socjordi/reflow-soldering-hotplate/README.md

# reflow-soldering-hotplate

This project is a reflow soldering hotplate. A reflow soldering hotplate is a heated surface used to solder surface-mount components onto a PCB by reflowing solder paste. It works by heating the PCB to a controlled temperature profile, melting the solder paste, and forming strong electrical and mechanical connections between the components and the board.

It's composed of a 500 W aluminium heating plate, a fan for the cooling phase, an ESP32-C3 microcontroller, an OLED display, 2 relays, a K-type thermopar and some other components. The total cost of materials was about 42 €.

The profiles can be read or write on wifi, as well as the log of the last reflow cycle.

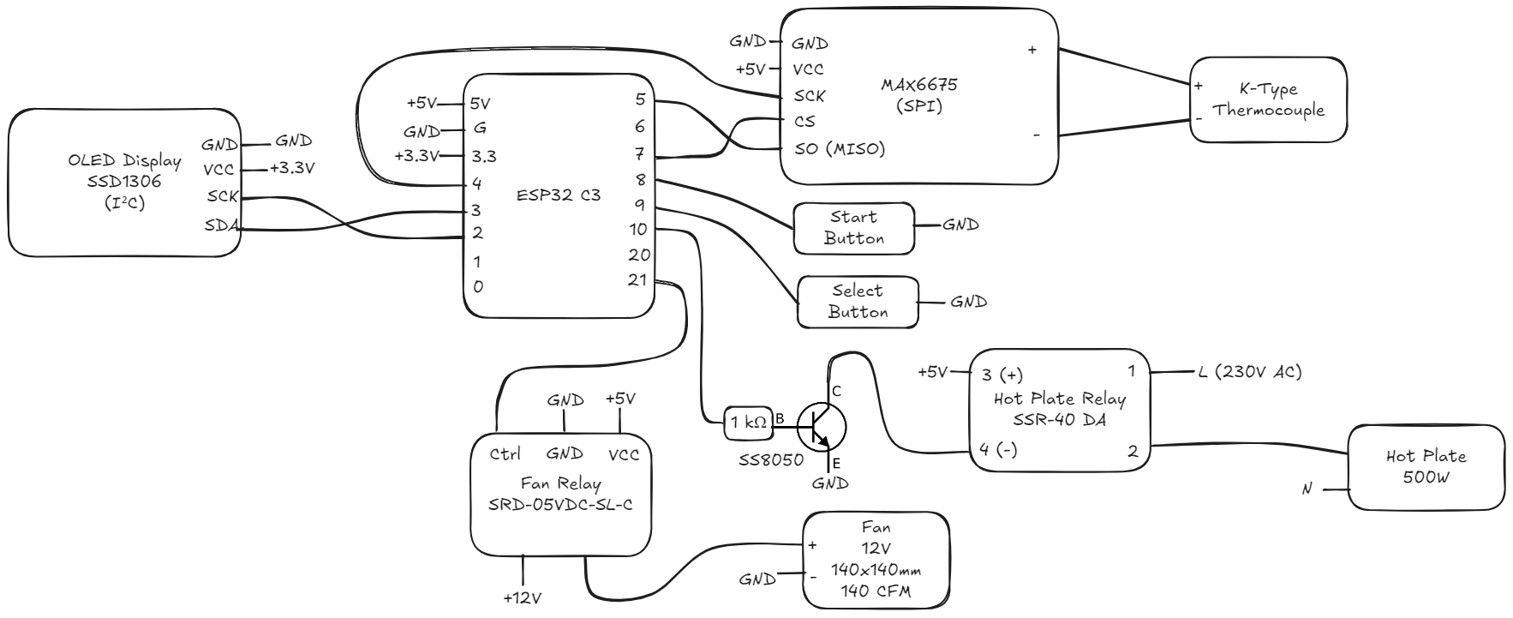
[picture p1: images/schematics.png]

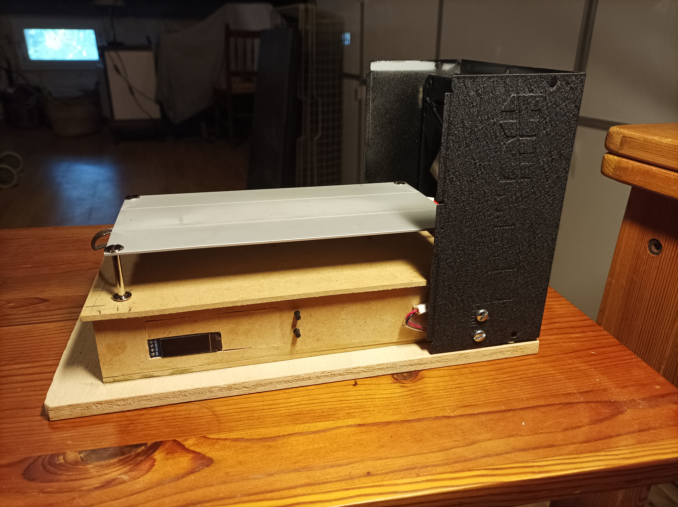
[picture p2: images/IMG_20250325_150605.jpg]

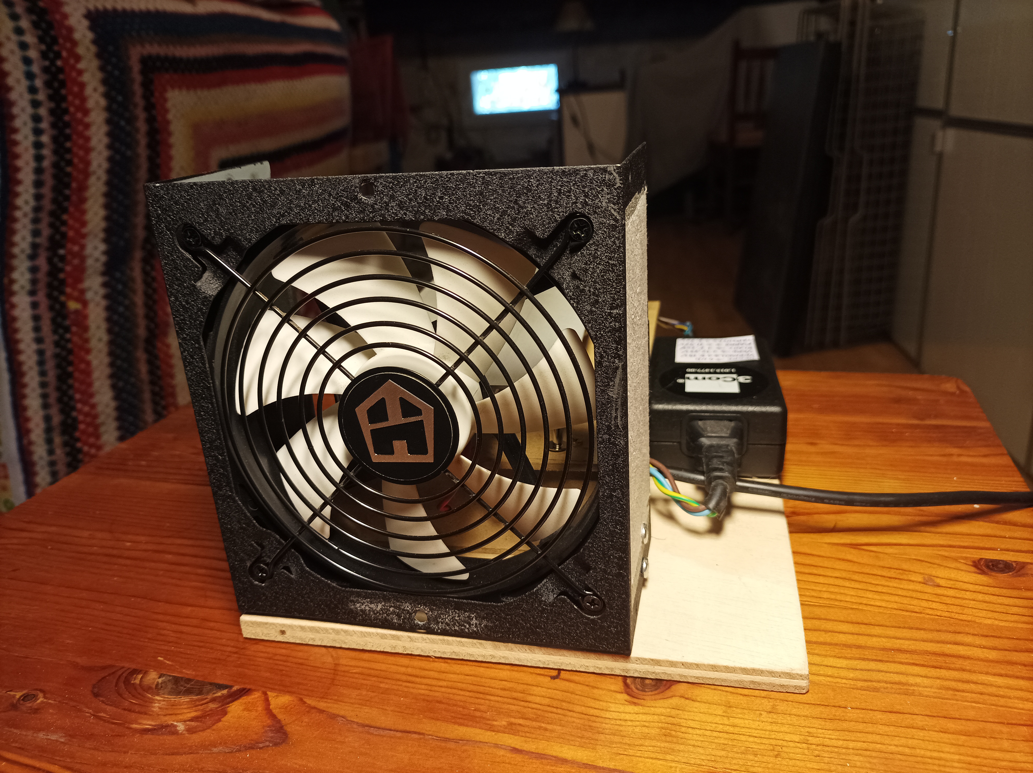
[picture p3: images/IMG_20250325_150620.jpg]

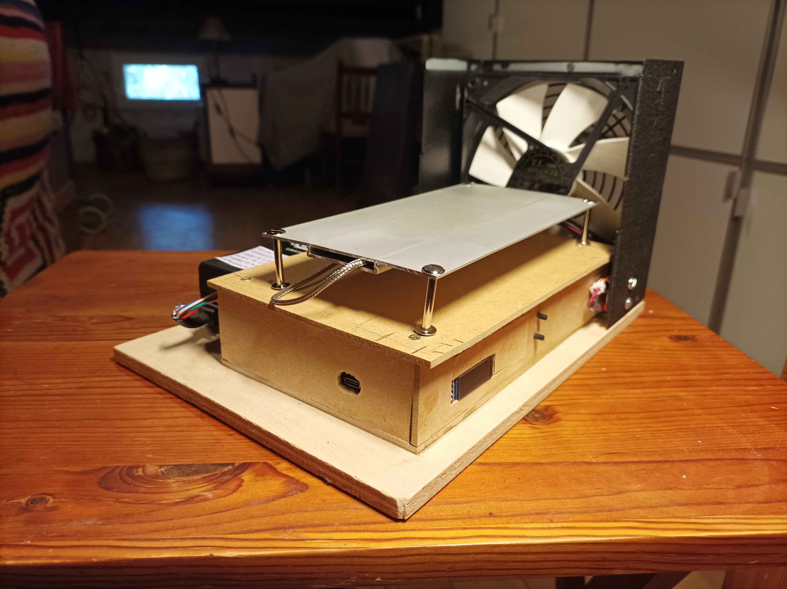
[picture p4: images/IMG_20250325_150632.jpg]

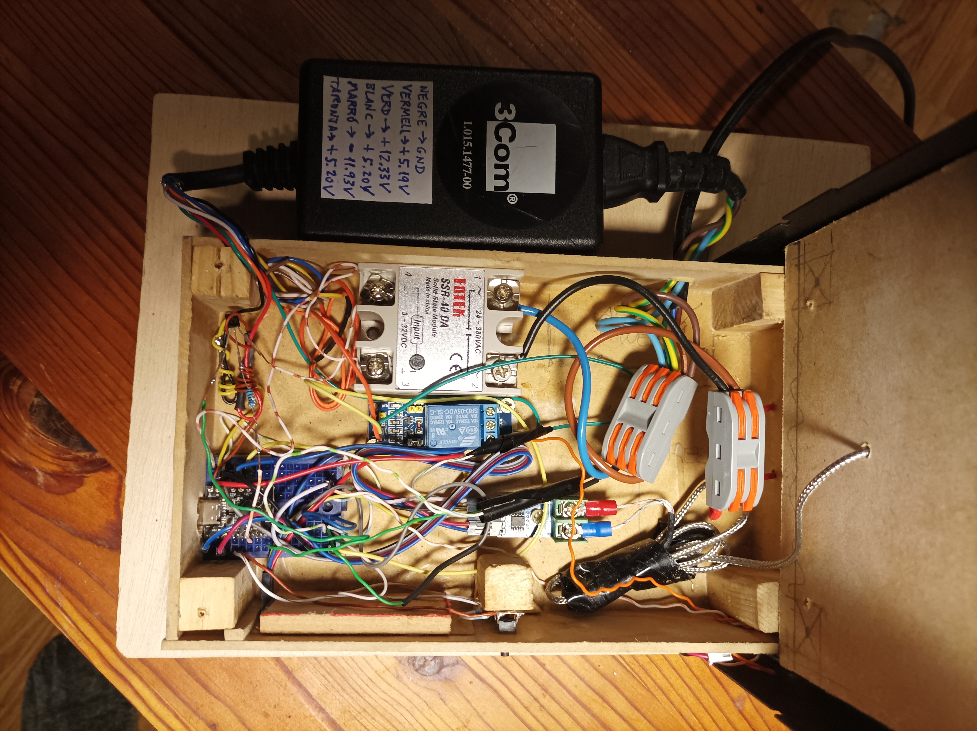
[picture p5: images/IMG_20250325_150800.jpg]

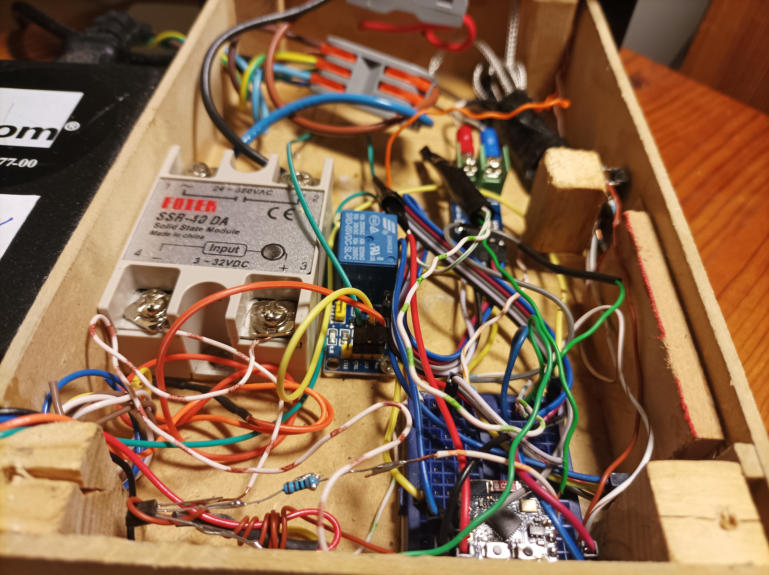
[picture p6: images/IMG_20250325_150813.jpg]


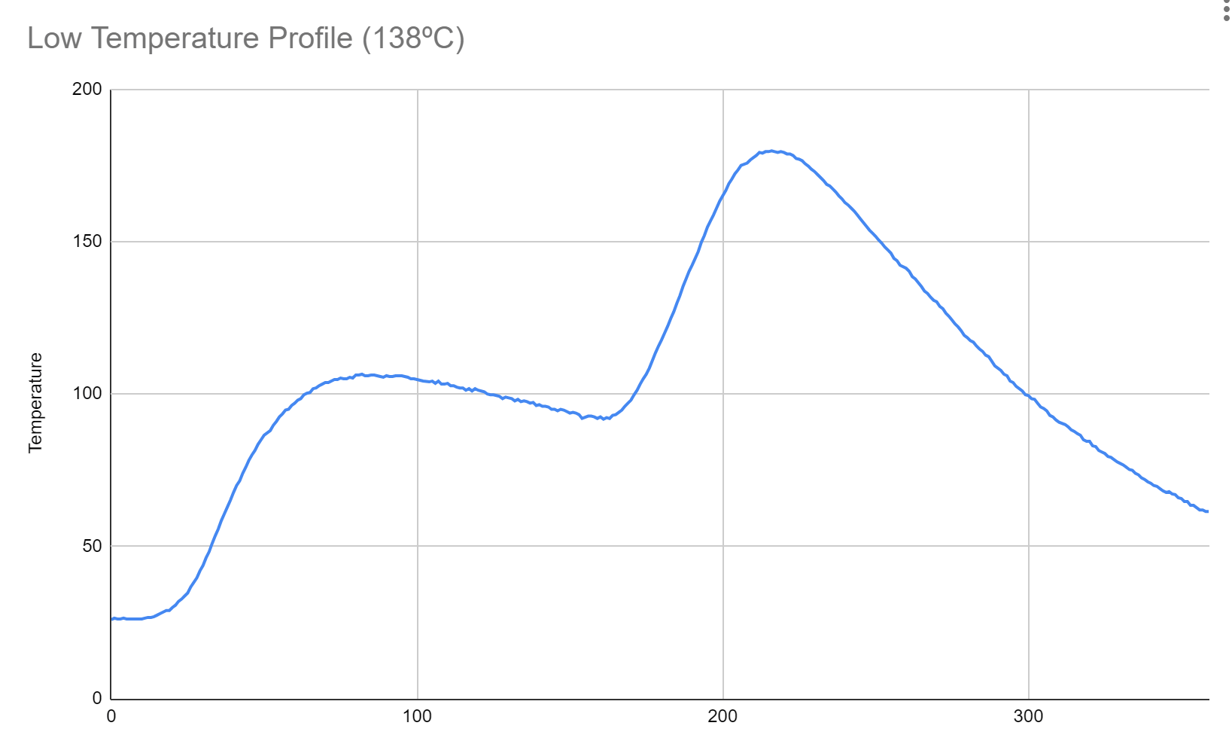
[picture p7: images/low_temp_profile.png]

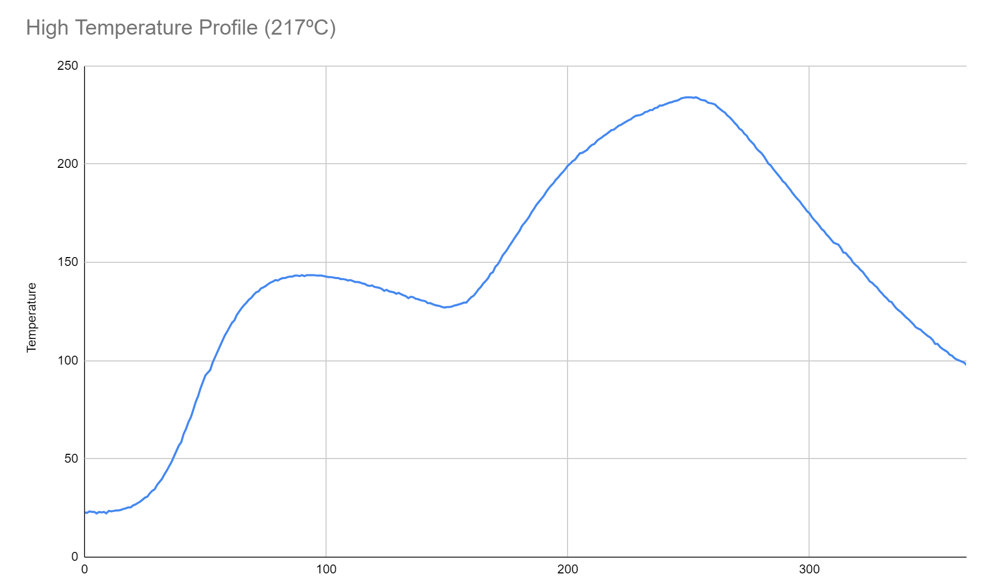
[picture p8: images/high_temp_profile.png]


Bill of materials (41.94 €):

- Module ESP32-C3 super mini (2.54 €)
- SSD1306 OLED display 128x32px (4.00 €)
- SSR-40 DA relay (3.89 €)
- SRD-05VDC-SL-C relay module (2.00 €)
- MAX6675 module (1.91 €)
- K-type thermopar (2.33 €)
- 2 buttons (0.12 €)
- 1 NPN transistor SS8050 (0.06 €)
- Aluminium electric heating plate 500W (9.09 €)
- Fan 12V, 140x140mm, 140 CFM (11.00 €)
- Power adapter 12V / 5V (5.00 €)
